Yendang1206/Measuring-Temperature-with-the-LM35-sensor/(list of files, drawings)

Other design files:
layout_transmitter.pcb
